kamibababa/xv6-riscv-fpga/(commit log)

2023-03-09 changed size of thinker
    [cube.scad]
2023-03-09 changed rear to fit better
    [cube.scad]
2023-03-15 moved hole for GPIO slightly to the right
    [cube.blend, front.blend, logo1.blend, logo2.blend, logo3.blend, nothing.blend, rear.blend, rip.blend]
